TheAccomplice/Time/l3/l3.kicad_pcb

## KiCad design l3/l3.kicad_pcb (2025-02-14)

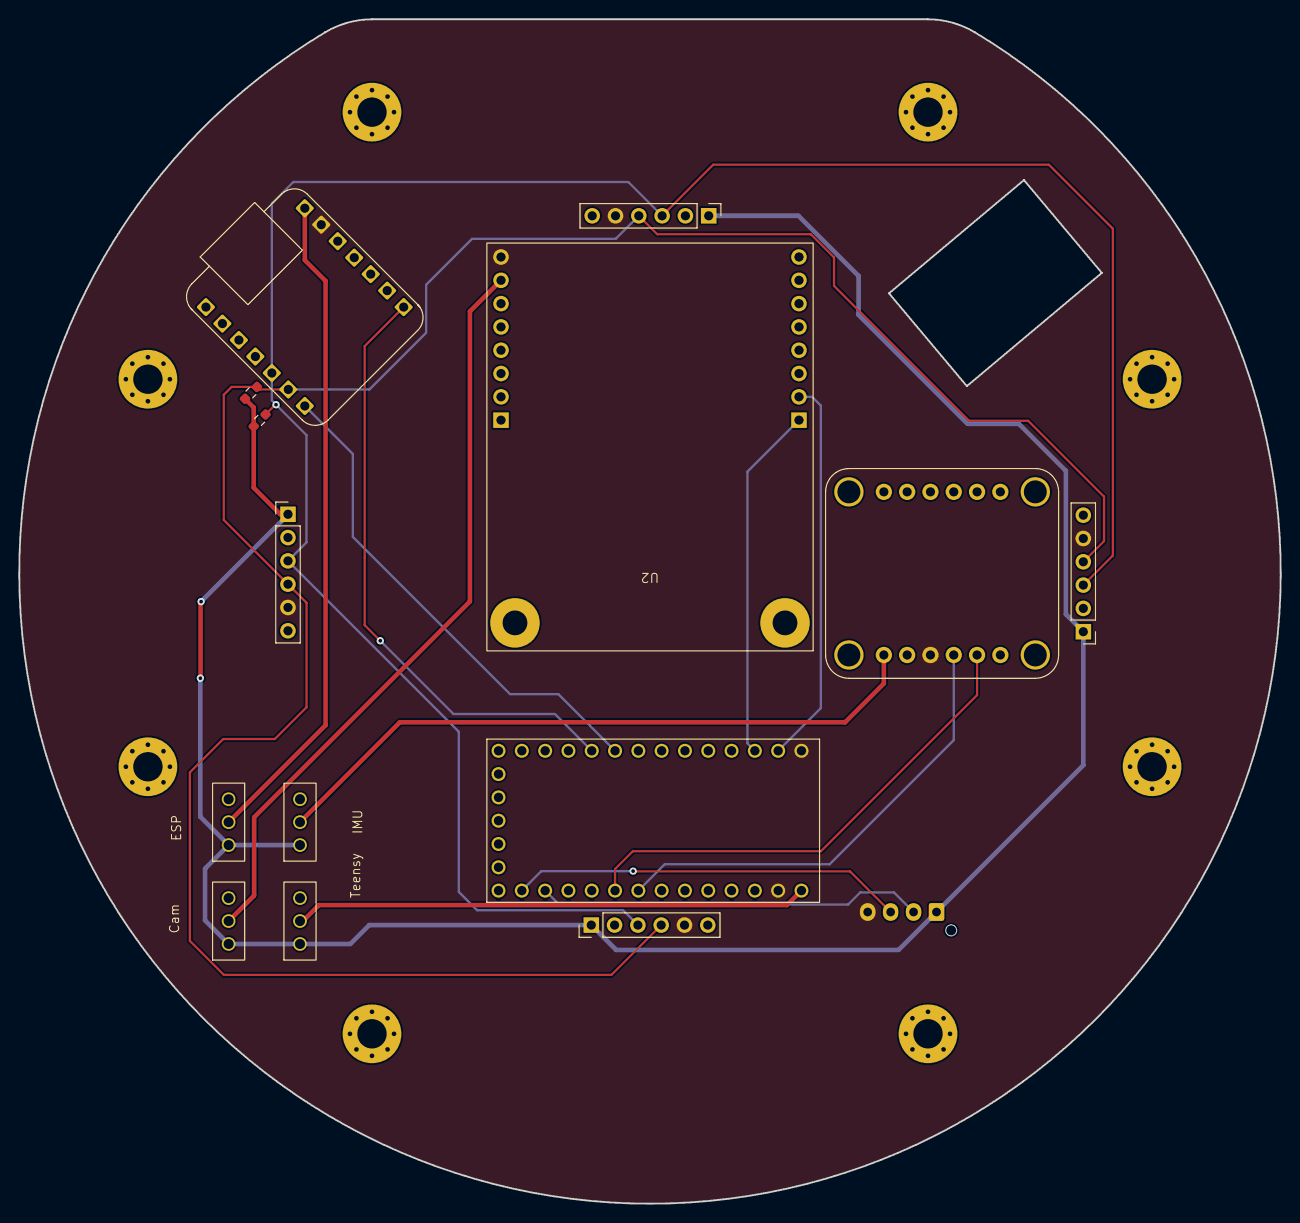
[picture p2: board l3.kicad_pcb from above]

Board: 2 copper layers, 137.5 x 129.1 mm, 23 parts (1 on the bottom side), 16 nets.

Parts:
Cam: SW_SPDT; SS12D00G3-2.5mm
ESP: SW_SPDT; SS12D00G3-2.5mm
H1, H2, H3, H4, H5, H6, H7, H8: MountingHole_Pad; MountingHole_3.2mm_M3_Pad_Via
IMU: SW_SPDT; SS12D00G3-2.5mm
J1: Conn_01x04; JST_XH_B4B-XH-AM_1x04_P2.50mm_Vertical
J2, J3, J4, J5: Conn_01x06; PinHeader_1x06_P2.54mm_Vertical
R1, R2: 1k; R_0603_1608Metric_Pad0.98x0.95mm_HandSolder
Teensy: SW_SPDT; SS12D00G3-2.5mm
U1: BNO085
U2: OpenMV
U3: xiao-esp32c3
U4: DEV-15583; MODULE_DEV-15583

Connections:
+5V: Cam.1 (A), ESP.1 (A), IMU.1 (A), J1.1, J2.1, J3.1, J4.1, J5.1, R1.2, R2.2, Teensy.1 (A)
/CameraSwitch: Cam.2 (B), U2.15 (VIN)
/CompassSwitch: IMU.2 (B), U1.0 (VIN)
/ESPSwitch: ESP.2 (B), U3.13 (5V)
/RXCam: U2.2 (P1), U4.0
/RXL2: J1.2, U4.15
/RXToF: U3.7 (D7), U4.8
/SCLComp: U1.3 (SCL/SCK/RX), U4.19
/SDAComp: U1.4 (SDA/MISO/TX), U4.18
/TXCam: U2.1 (P0), U4.1
/TXL2: J1.3, U4.14
/TXToF: U3.6 (D6), U4.7
/TeensySwitch: Teensy.2 (B), U4.VIN
GND: J1.4, J2.5, J3.5, J4.5, J5.5, U1.2 (GND), U2.16 (GND), U3.12 (GND), U4.G1, U4.G3 (GND)
SCLToF: J2.4, J3.4, J4.4, J5.4, R2.1, U3.5 (D5)
SDAToF: J2.3, J3.3, J4.3, J5.3, R1.1, U3.4 (D4)
