TheAccomplice/Time/l2/l2.kicad_pcb

## KiCad design l2/l2.kicad_pcb (2025-02-14)

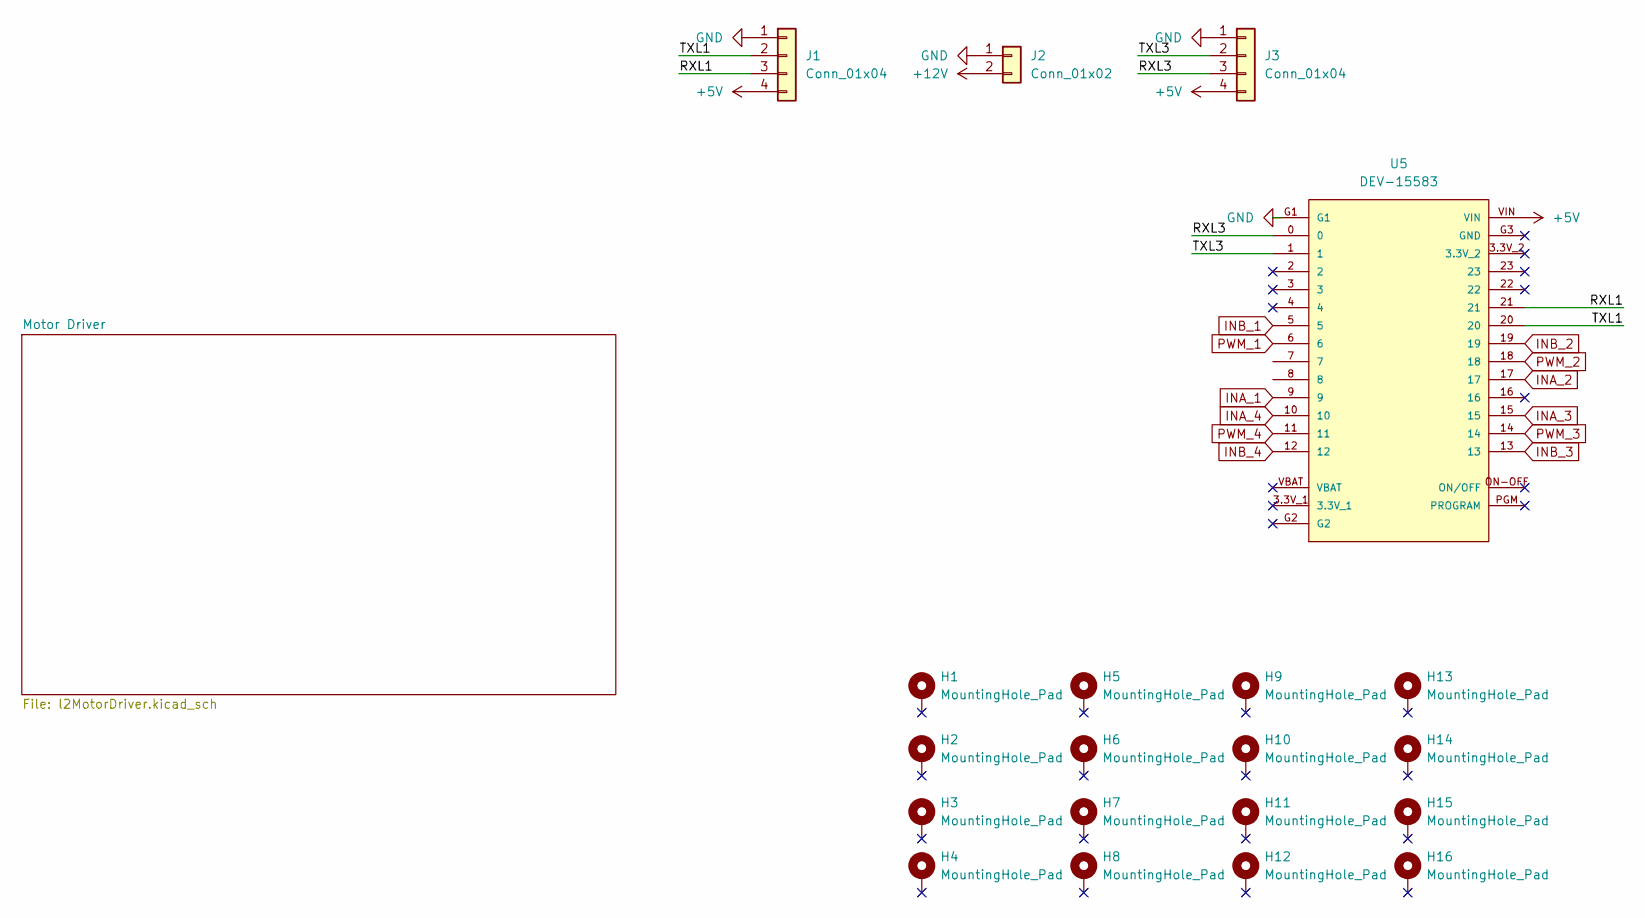
[picture p3: schematic l2.kicad_sch]

Parts:
H1, H2, H3, H4, H5, H6, H7, H8, H9, H10, H11, H12, H13, H14, H15, H16: MountingHole_Pad; MountingHole_3.2mm_M3_Pad_Via
J1, J3: Conn_01x04; JST_XH_B4B-XH-AM_1x04_P2.50mm_Vertical
J2: Conn_01x02; AMASS_XT60-M_1x02_P7.20mm_Vertical
U5: DEV-15583; MODULE_DEV-15583

Connections:
+5V: J1.4, J3.4, U5.VIN; also elsewhere on the board
+12V: J2.2; also elsewhere on the board
/RXL1: J1.3, U5.21
/RXL3: J3.3, U5.0
/TXL1: J1.2, U5.20
/TXL3: J3.2, U5.1
GND: J1.1, J2.1, J3.1, U5.G1; also elsewhere on the board
INA_1: U5.9; also elsewhere on the board
INA_2: U5.17; also elsewhere on the board
INA_3: U5.15; also elsewhere on the board
INA_4: U5.10; also elsewhere on the board
INB_1: U5.5; also elsewhere on the board
INB_2: U5.19; also elsewhere on the board
INB_3: U5.13; also elsewhere on the board
INB_4: U5.12; also elsewhere on the board
PWM_1: U5.6; also elsewhere on the board
PWM_2: U5.18; also elsewhere on the board
PWM_3: U5.14; also elsewhere on the board
PWM_4: U5.11; also elsewhere on the board

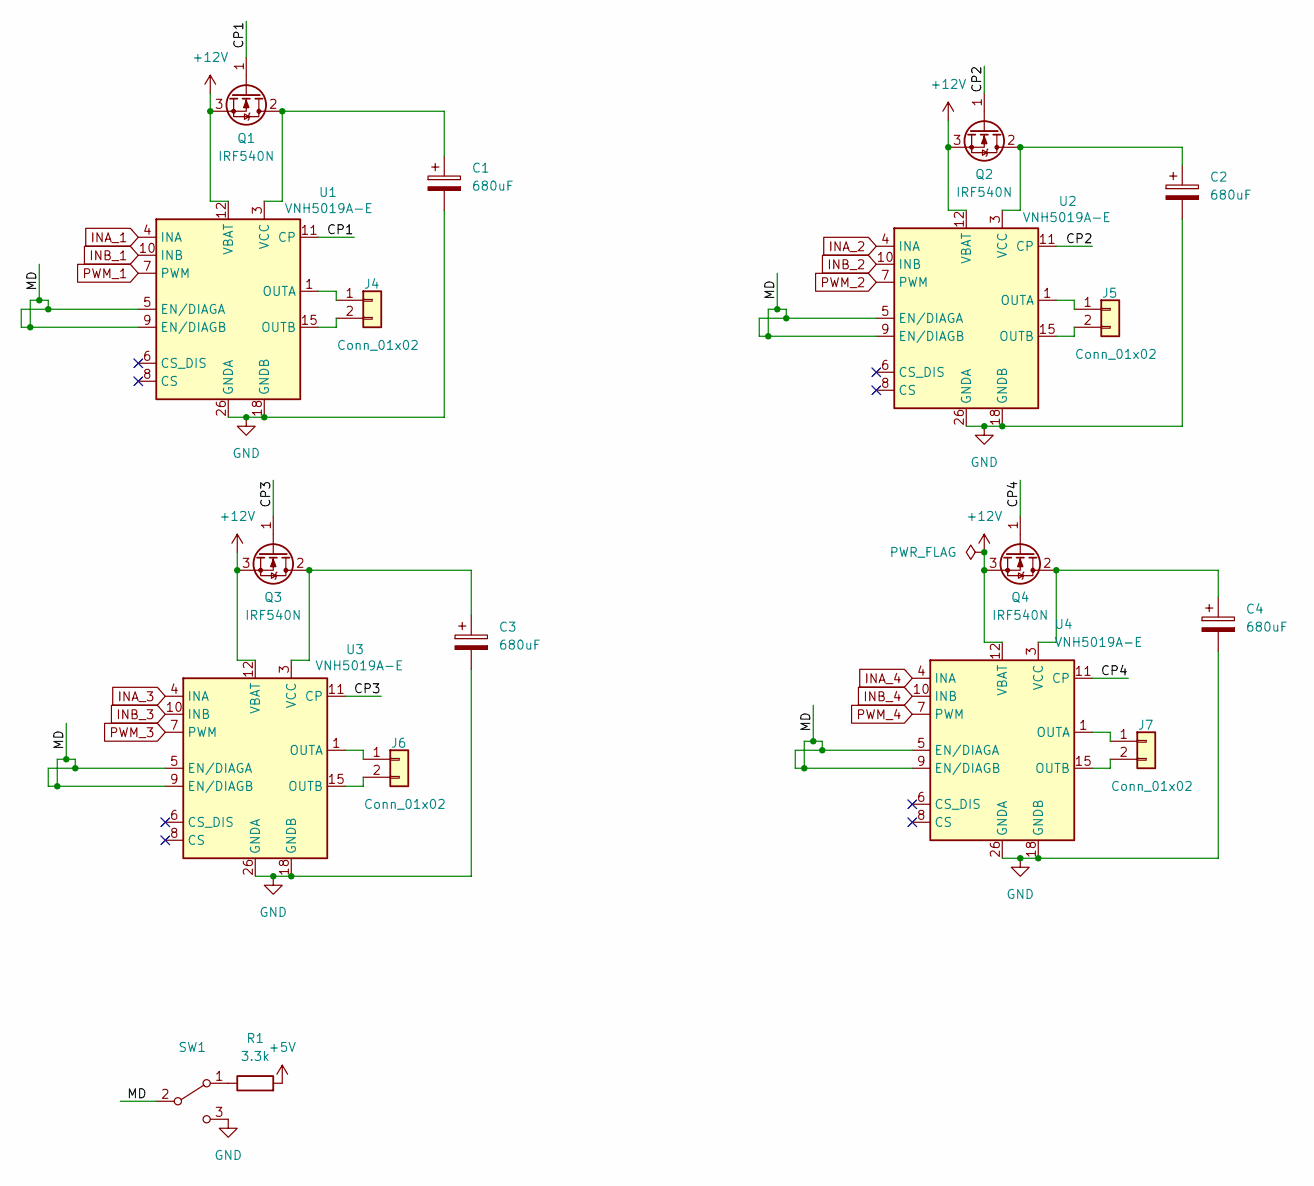
[picture p4: schematic l2MotorDriver.kicad_sch]

Parts:
C1, C2, C3, C4: 680uF; CP_Radial_D8.0mm_P3.50mm
J4, J5, J6, J7: Conn_01x02; AMASS_XT30UPB-F_1x02_P5.0mm_Vertical
Q1, Q2, Q3, Q4: IRF540N; TO-220-3_Vertical
R1: 3.3k; R_0603_1608Metric_Pad0.98x0.95mm_HandSolder
SW1: SW_SPDT; JST_XH_B3B-XH-AM_1x03_P2.50mm_Vertical
U1, U2, U3, U4: VNH5019A-E; VNH5019A-E_SO-30

Connections:
+5V: R1.2; also elsewhere on the board
+12V: Q1.3 (S), Q2.3 (S), Q3.3 (S), Q4.3 (S), U1.12 (VBAT), U2.12 (VBAT), U3.12 (VBAT), U4.12 (VBAT); also elsewhere on the board
/Motor Driver/CP1: Q1.1 (G), U1.11 (CP)
/Motor Driver/CP2: Q2.1 (G), U2.11 (CP)
/Motor Driver/CP3: Q3.1 (G), U3.11 (CP)
/Motor Driver/CP4: Q4.1 (G), U4.11 (CP)
/Motor Driver/MD: SW1.2 (B), U1.5 (EN/DIAGA), U1.9 (EN/DIAGB), U2.5 (EN/DIAGA), U2.9 (EN/DIAGB), U3.5 (EN/DIAGA), U3.9 (EN/DIAGB), U4.5 (EN/DIAGA), U4.9 (EN/DIAGB)
GND: C1.2, C2.2, C3.2, C4.2, SW1.3 (C), U1.18 (GNDB), U1.19 (GNDB), U1.20 (GNDB), U1.26 (GNDA), U1.27 (GNDA), U1.28 (GNDA), U2.18 (GNDB), U2.19 (GNDB), U2.20 (GNDB), U2.26 (GNDA), U2.27 (GNDA), U2.28 (GNDA), U3.18 (GNDB), U3.19 (GNDB), U3.20 (GNDB), U3.26 (GNDA), U3.27 (GNDA), U3.28 (GNDA), U4.18 (GNDB), U4.19 (GNDB), U4.20 (GNDB), U4.26 (GNDA), U4.27 (GNDA), U4.28 (GNDA); also elsewhere on the board
INA_1: U1.4 (INA); also elsewhere on the board
INA_2: U2.4 (INA); also elsewhere on the board
INA_3: U3.4 (INA); also elsewhere on the board
INA_4: U4.4 (INA); also elsewhere on the board
INB_1: U1.10 (INB); also elsewhere on the board
INB_2: U2.10 (INB); also elsewhere on the board
INB_3: U3.10 (INB); also elsewhere on the board
INB_4: U4.10 (INB); also elsewhere on the board
unnamed: J4.1, U1.1 (OUTA), U1.25 (OUTA), U1.30 (OUTA), U1.33 (OUTA)
unnamed: J4.2, U1.15 (OUTB), U1.16 (OUTB), U1.21 (OUTB), U1.32 (OUTB)
unnamed: J5.1, U2.1 (OUTA), U2.25 (OUTA), U2.30 (OUTA), U2.33 (OUTA)
unnamed: J5.2, U2.15 (OUTB), U2.16 (OUTB), U2.21 (OUTB), U2.32 (OUTB)
unnamed: J6.1, U3.1 (OUTA), U3.25 (OUTA), U3.30 (OUTA), U3.33 (OUTA)
unnamed: J6.2, U3.15 (OUTB), U3.16 (OUTB), U3.21 (OUTB), U3.32 (OUTB)
unnamed: J7.1, U4.1 (OUTA), U4.25 (OUTA), U4.30 (OUTA), U4.33 (OUTA)
unnamed: J7.2, U4.15 (OUTB), U4.16 (OUTB), U4.21 (OUTB), U4.32 (OUTB)
unnamed: C1.1, Q1.2 (D), U1.3 (VCC), U1.13 (VCC), U1.23 (VCC), U1.31 (VCC)
unnamed: C2.1, Q2.2 (D), U2.3 (VCC), U2.13 (VCC), U2.23 (VCC), U2.31 (VCC)
unnamed: C3.1, Q3.2 (D), U3.3 (VCC), U3.13 (VCC), U3.23 (VCC), U3.31 (VCC)
unnamed: C4.1, Q4.2 (D), U4.3 (VCC), U4.13 (VCC), U4.23 (VCC), U4.31 (VCC)
unnamed: R1.1, SW1.1 (A)
PWM_1: U1.7 (PWM); also elsewhere on the board
PWM_2: U2.7 (PWM); also elsewhere on the board
PWM_3: U3.7 (PWM); also elsewhere on the board
PWM_4: U4.7 (PWM); also elsewhere on the board

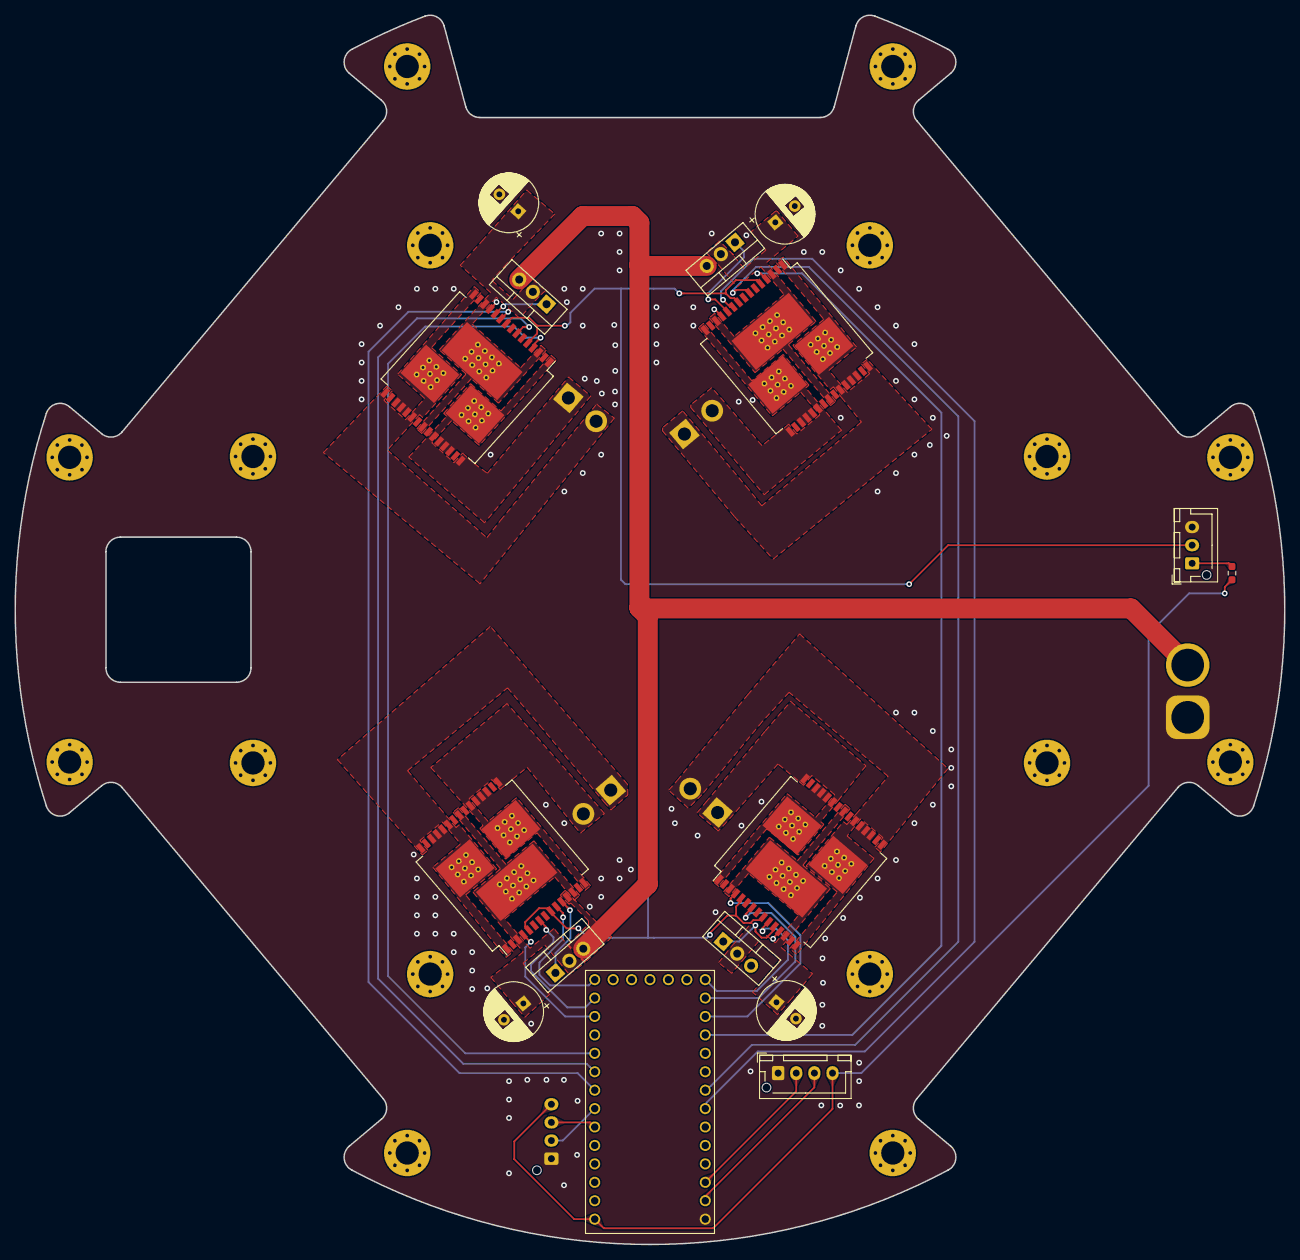
[picture p5: board l2.kicad_pcb from above]

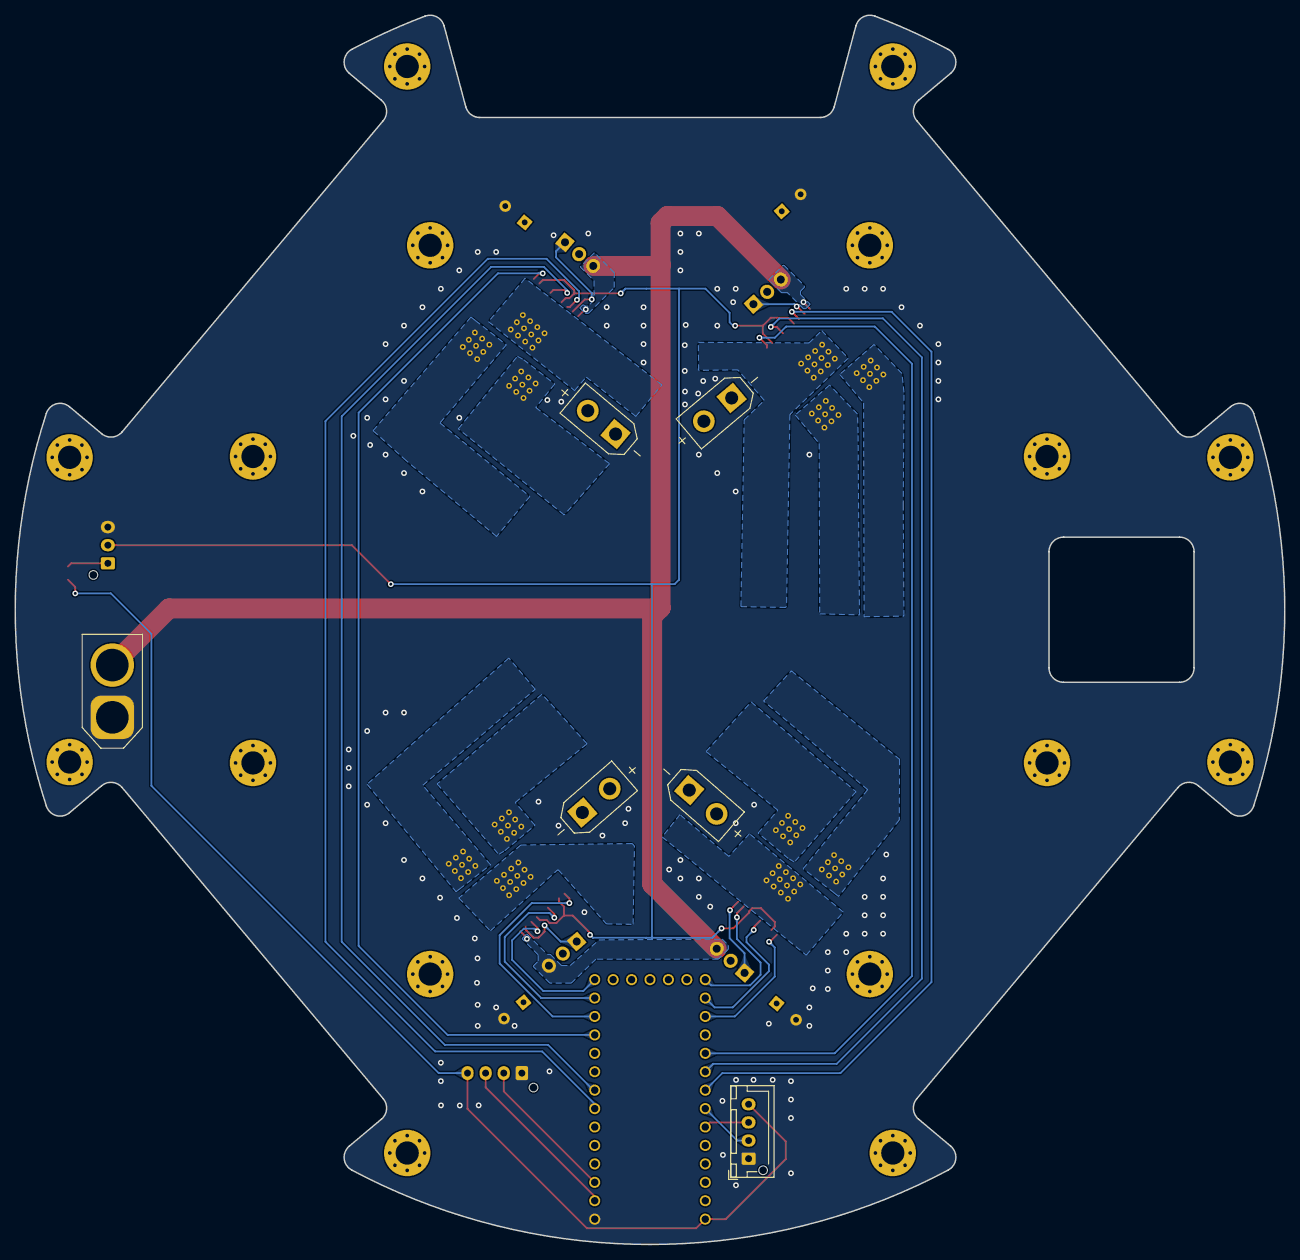
[picture p6: board l2.kicad_pcb from below]

Board: 2 copper layers, 175.0 x 169.4 mm, 38 parts (6 on the bottom side), 37 nets.
