TheAccomplice/Time/l1/l1.kicad_pcb

## KiCad design l1/l1.kicad_pcb (2024-11-28)

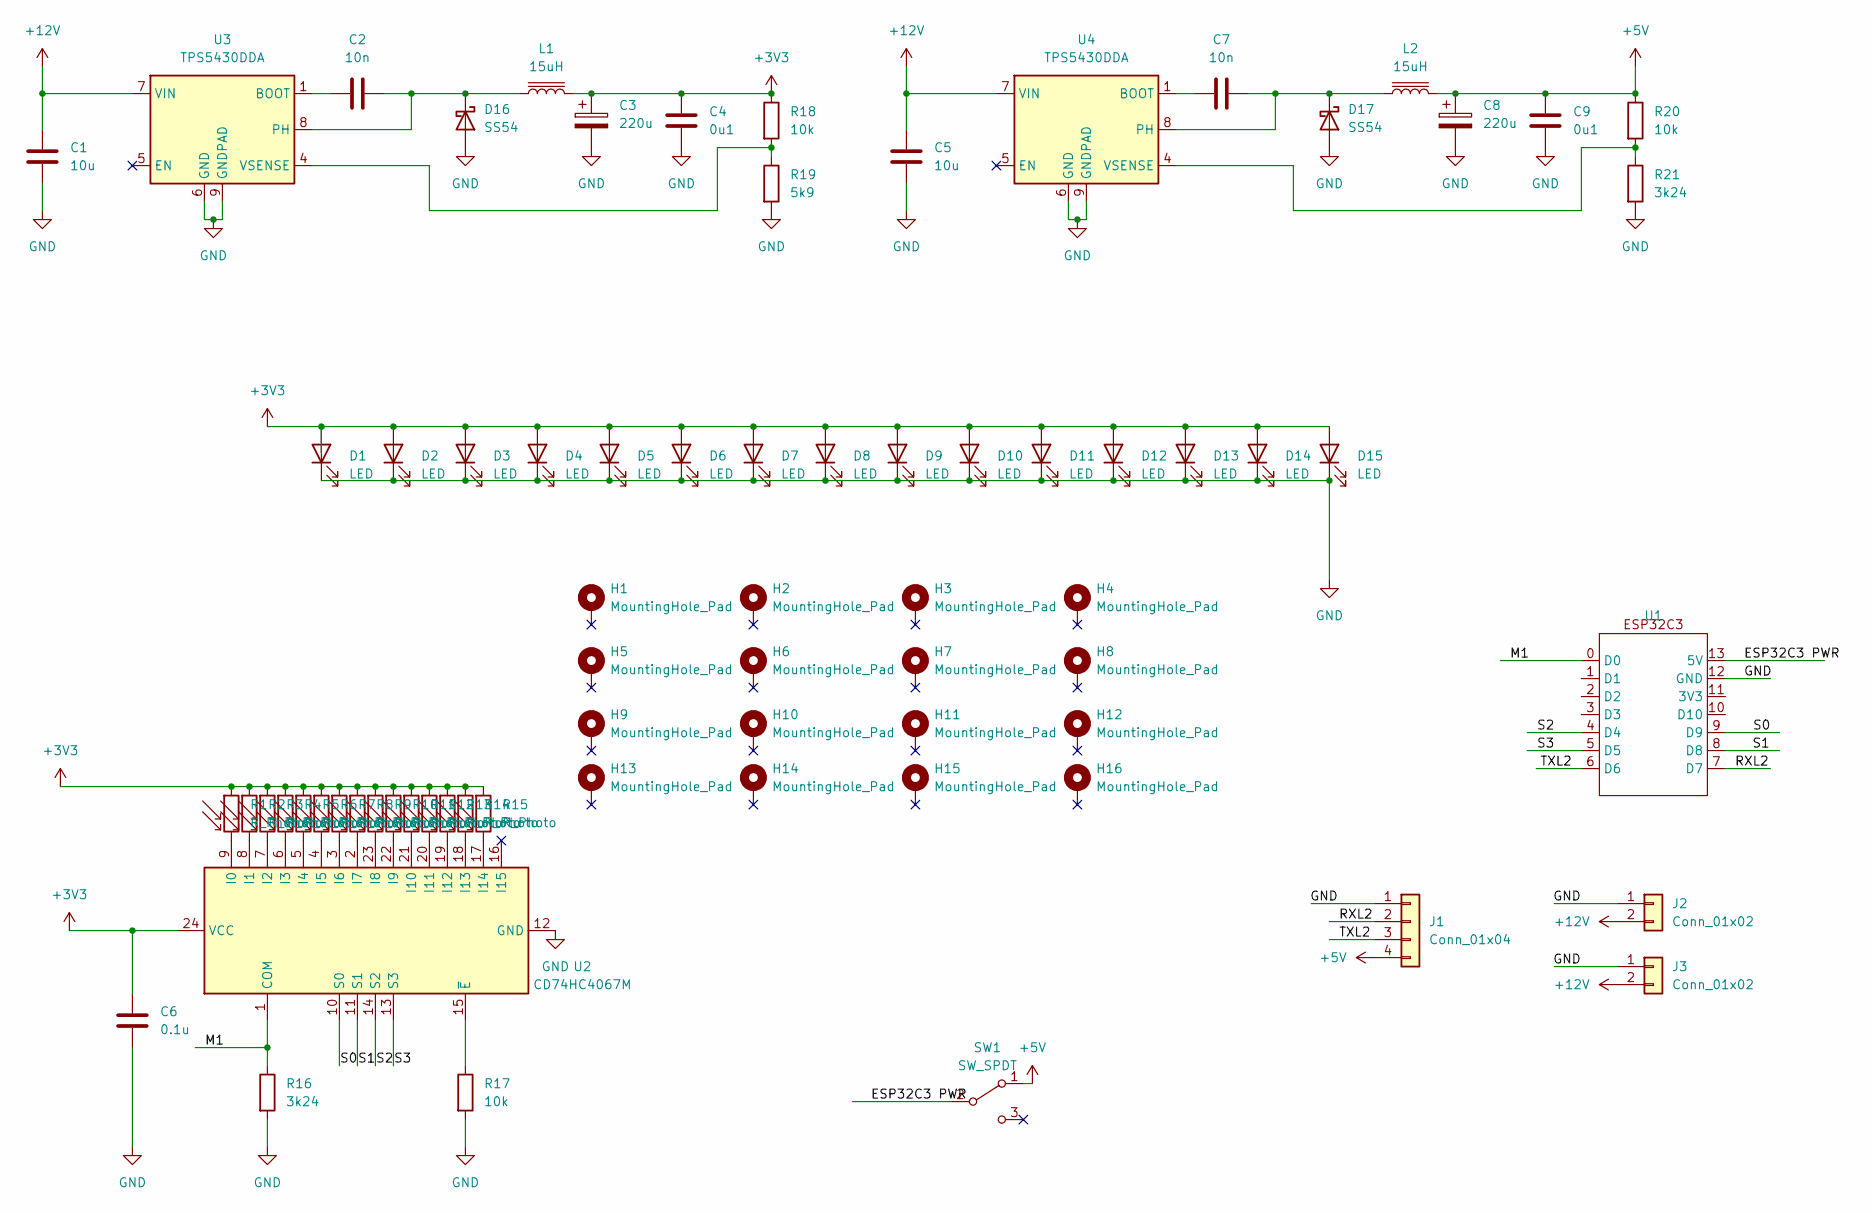
[picture p7: schematic l1.kicad_sch]

Parts:
C1, C5: 10u; C_0603_1608Metric_Pad1.08x0.95mm_HandSolder
C2, C7: 10n; C_0603_1608Metric_Pad1.08x0.95mm_HandSolder
C3, C8: 220u; CP_EIA-7343-15_Kemet-W_Pad2.25x2.55mm_HandSolder
C4, C9: 0u1; C_0603_1608Metric_Pad1.08x0.95mm_HandSolder
C6: 0.1u; C_0603_1608Metric_Pad1.08x0.95mm_HandSolder
D1, D2, D3, D4, D5, D6, D7, D8, D9, D10, D11, D12, D13, D14, D15: LED; LED_PLCC_2835_Handsoldering
D16, D17: SS54; D_SMA_Handsoldering
H1, H2, H3, H4, H5, H6, H7, H8, H9, H10, H11, H12, H13, H14, H15, H16: MountingHole_Pad; MountingHole_3.2mm_M3_Pad_Via
J1: Conn_01x04; JST_XH_B4B-XH-AM_1x04_P2.50mm_Vertical
J2, J3: Conn_01x02; AMASS_XT60-M_1x02_P7.20mm_Vertical
L1, L2: 15uH; L_Bourns_SRR1208_12.7x12.7mm
R1, R2, R3, R4, R5, R6, R7, R8, R9, R10, R11, R12, R13, R14, R15: R_Photo; LED_0603_1608Metric
R16, R21: 3k24; R_0603_1608Metric_Pad0.98x0.95mm_HandSolder
R17, R18, R20: 10k; R_0603_1608Metric_Pad0.98x0.95mm_HandSolder
R19: 5k9; R_0603_1608Metric_Pad0.98x0.95mm_HandSolder
SW1: SW_SPDT; SS12D00G3-2.5mm
U1: xiao-esp32c3
U2: CD74HC4067M; SOIC-24W_7.5x15.4mm_P1.27mm
U3, U4: TPS5430DDA; TI_SO-PowerPAD-8_ThermalVias

Connections:
+3V3: C3.1, C4.1, C6.1, D1.2 (A), D2.2 (A), D3.2 (A), D4.2 (A), D5.2 (A), D6.2 (A), D7.2 (A), D8.2 (A), D9.2 (A), D10.2 (A), D11.2 (A), D12.2 (A), D13.2 (A), D14.2 (A), D15.2 (A), L1.2, R1.1, R2.1, R3.1, R4.1, R5.1, R6.1, R7.1, R8.1, R9.1, R10.1, R11.1, R12.1, R13.1, R14.1, R15.1, R18.1, U2.24 (VCC)
+5V: C8.1, C9.1, J1.4, L2.2, R20.1, SW1.1 (A)
+12V: C1.1, C5.1, J2.2, J3.2, U3.7 (VIN), U4.7 (VIN)
/ESP32C3 PWR: SW1.2 (B), U1.13 (5V)
/M1: R16.1, U1.0 (D0), U2.1 (COM)
/RXL2: J1.2, U1.7 (D7)
/S0: U1.9 (D9), U2.10 (S0)
/S1: U1.8 (D8), U2.11 (S1)
/S2: U1.4 (D4), U2.14 (S2)
/S3: U1.5 (D5), U2.13 (S3)
/TXL2: J1.3, U1.6 (D6)
GND: C1.2, C3.2, C4.2, C5.2, C6.2, C8.2, C9.2, D1.1 (K), D2.1 (K), D3.1 (K), D4.1 (K), D5.1 (K), D6.1 (K), D7.1 (K), D8.1 (K), D9.1 (K), D10.1 (K), D11.1 (K), D12.1 (K), D13.1 (K), D14.1 (K), D15.1 (K), D16.2 (A), D17.2 (A), J1.1, J2.1, J3.1, R16.2, R17.2, R19.2, R21.2, U1.12 (GND), U2.12 (GND), U3.6 (GND), U3.9 (GNDPAD), U4.6 (GND), U4.9 (GNDPAD)
unnamed: C2.2, D16.1 (K), L1.1, U3.8 (PH)
unnamed: C7.2, D17.1 (K), L2.1, U4.8 (PH)
unnamed: R1.2, U2.9 (I0)
unnamed: R2.2, U2.8 (I1)
unnamed: R3.2, U2.7 (I2)
unnamed: R4.2, U2.6 (I3)
unnamed: R5.2, U2.5 (I4)
unnamed: R6.2, U2.4 (I5)
unnamed: R7.2, U2.3 (I6)
unnamed: R8.2, U2.2 (I7)
unnamed: R9.2, U2.23 (I8)
unnamed: R10.2, U2.22 (I9)
unnamed: R11.2, U2.21 (I10)
unnamed: R12.2, U2.20 (I11)
unnamed: R13.2, U2.19 (I12)
unnamed: R14.2, U2.18 (I13)
unnamed: R15.2, U2.17 (I14)
unnamed: R17.1, U2.15 (~E)
unnamed: C2.1, U3.1 (BOOT)
unnamed: R18.2, R19.1, U3.4 (VSENSE)
unnamed: C7.1, U4.1 (BOOT)
unnamed: R20.2, R21.1, U4.4 (VSENSE)

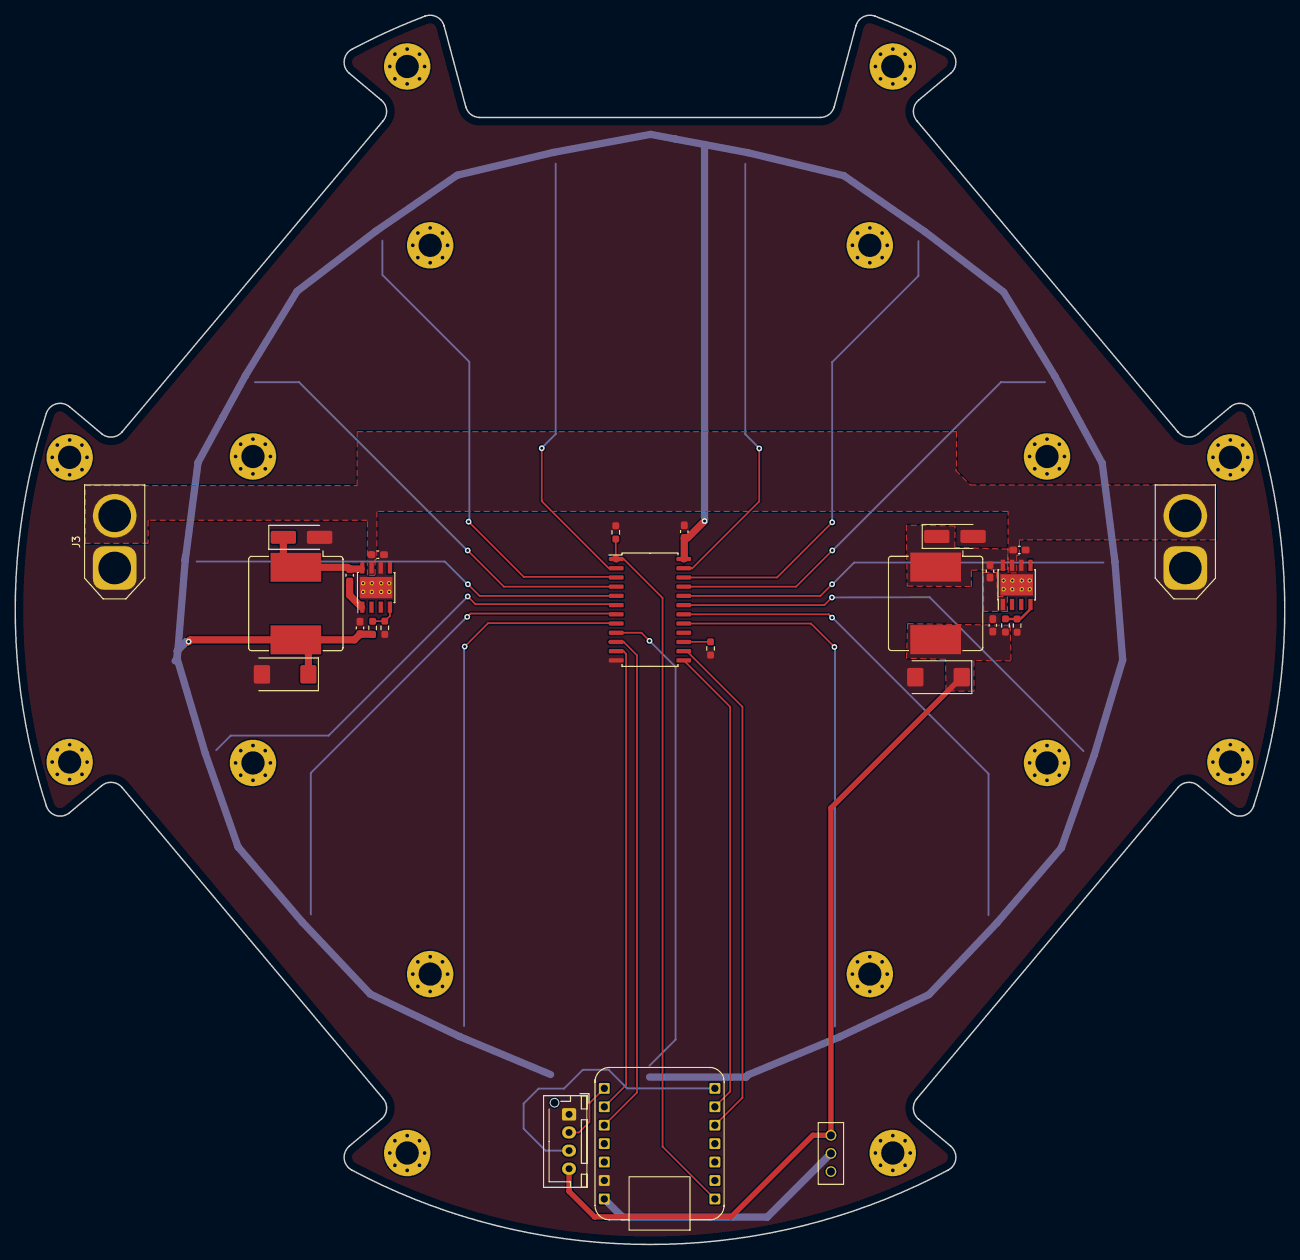
[picture p8: board l1.kicad_pcb from above]

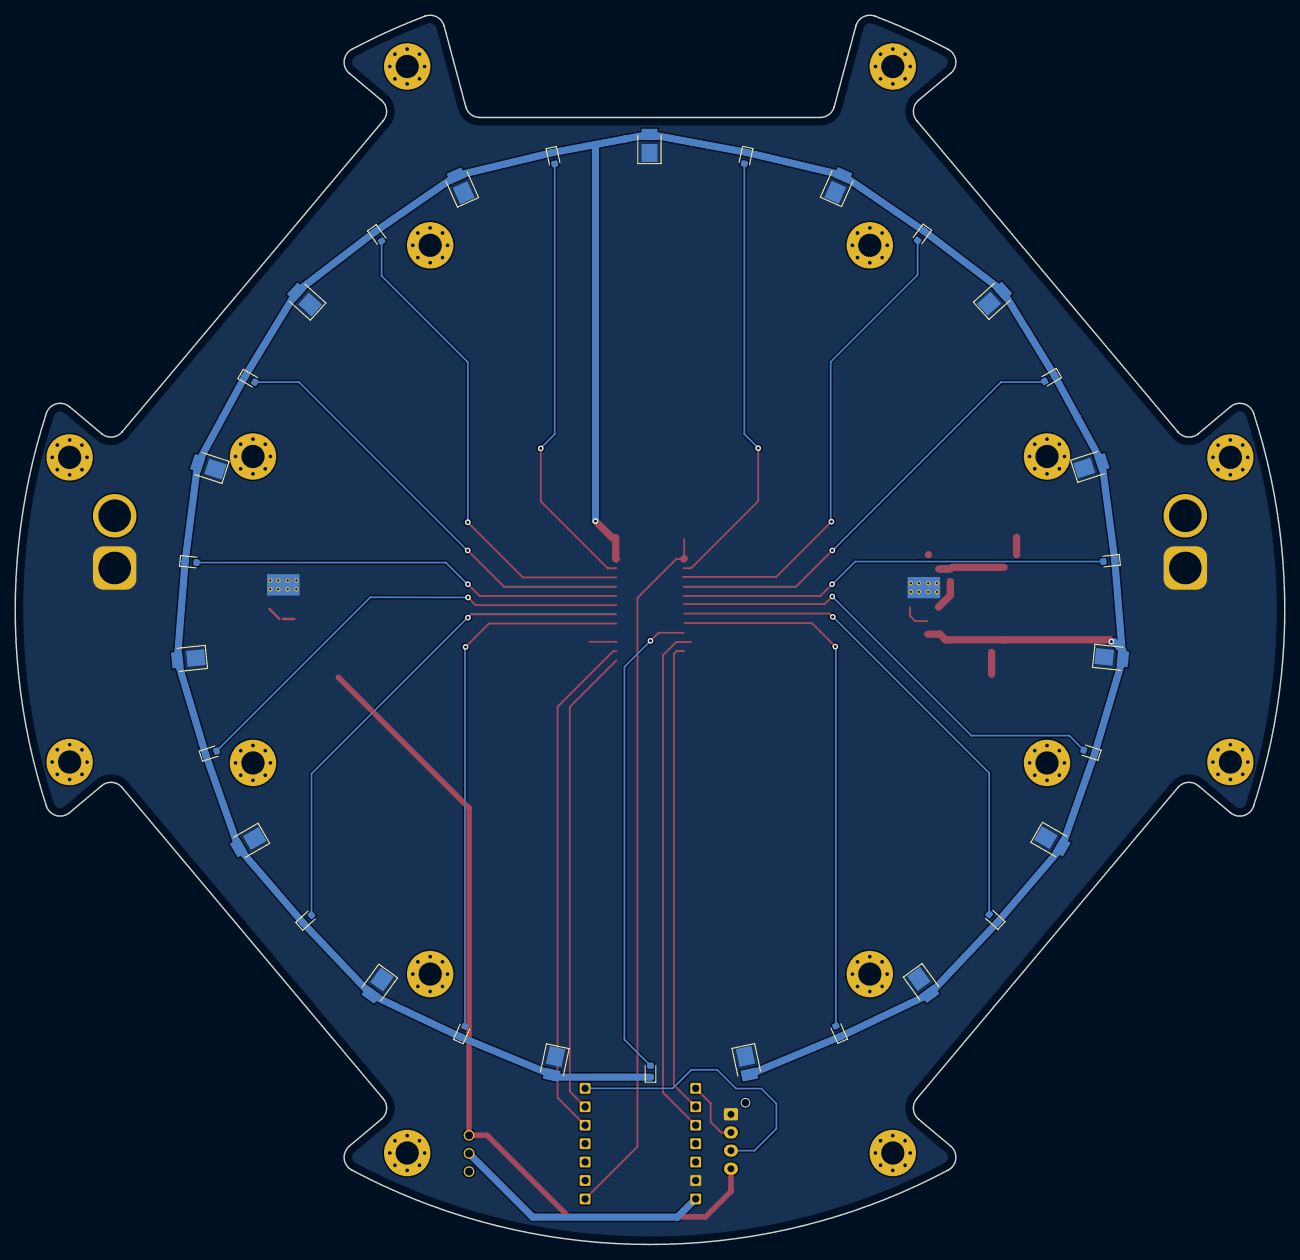
[picture p9: board l1.kicad_pcb from below]

Board: 2 copper layers, 175.0 x 169.4 mm, 73 parts (30 on the bottom side), 34 nets.
