TheAccomplice/Time/(commit log)

2024-07-05 Copy Over
    [Seeed Studio XIAO-ESP32-C3.step, buck.kicad_pcb, buck.kicad_sch, l1.kicad_pcb, l1.kicad_sch, l2.kicad_pcb, l2.kicad_sch, l3.kicad_pcb]
2024-07-05 readd trace
    [l3.kicad_pcb]
2024-07-05 2024 folder
    [Seeed Studio XIAO-ESP32-C3.step, buck.kicad_pcb, buck.kicad_sch, l1.kicad_pcb, l1.kicad_sch, l2.kicad_pcb, l2.kicad_sch, l3.kicad_pcb]
2024-07-05 remove trace test
    [l3.kicad_pcb]
2024-07-05 replace trace test
    [l3.kicad_pcb]
2024-07-05 another test
    [l3.kicad_pcb]
2024-07-05 add back trace
    [l3.kicad_pcb]
2024-07-05 pcb lck removed
2024-07-12 PCB_done
    Rearrange traces
    [l3.kicad_pcb]
2024-07-12 PCB done
    [l3.kicad_pcb]
2024-07-17 17/7 final
    [l2.kicad_sch]
2024-07-26 Motor Driver sch very wonky draft
    [l2.kicad_sch]
2024-07-26 26/7 final
    [l2.kicad_sch]
2024-07-31 31/7 final
    [l2.kicad_sch]
2024-08-02 Refined motor driver schematics
    L2 schematics basically good to go might need final senior's review
    [l2.kicad_sch, l2MotorDriver.kicad_sch, untitled.kicad_sch]
2024-08-07 7/8 part_I
    [l2.kicad_sch, l2MotorDriver.kicad_sch]
2024-08-07 7/8 final
    [l2.kicad_pcb, l2MotorDriver.kicad_sch]
2024-08-14 14/8 final
    [l2.kicad_sch, l2MotorDriver.kicad_sch]
2024-08-16 Fixed motor driver error
    VL53L1X is actual one
    [l3.kicad_sch, l3_tof.kicad_sch, untitled.kicad_sch]
2024-08-16 16/8 final
    [l2.kicad_pcb, l2.kicad_sch, l2MotorDriver.kicad_sch, l3.kicad_sch]
2024-08-21 21/8 final
    about 10% done l2 pcb
    [l2.kicad_pcb, l2.kicad_sch, l2MotorDriver.kicad_sch]
2024-08-21 21/8 final2
    still about 10% done l2 pcb
2024-08-28 28/8 final
    resistors for motor driver removed as it was too cumbersome to do the traces and is also completely optional
    [l2.kicad_pcb, l2MotorDriver.kicad_sch]
2024-09-04 4/9 final
    some cursed motor driver routing
    [l2.kicad_pcb]
2024-09-05 5/9 final
    fixed the problem with motor driver schematics
    [l2.kicad_pcb, l2.kicad_sch, l2MotorDriver.kicad_sch]
2024-09-08 edited motor driver pcb
    [l2.kicad_pcb]
2024-11-24 final 0.9
    [l1.kicad_pcb, l1.kicad_sch, l2.kicad_pcb, l2.kicad_sch, l2MotorDriver.kicad_sch, l3.kicad_pcb, l3.kicad_sch, l3_tof.kicad_sch]
2024-11-28 final 0.91
    fixed:
    switched analog signal pin on l1 esp32c3 to a0 since a1 not working
    silkscreen is now properly placed
    traces are adjusted on l1
    [l1.kicad_pcb, l1.kicad_sch, l2.kicad_pcb]
2024-11-29 tf luna
    gerber created for l1 and l2
    l3 changed the tof from vl53l1x to tf luna
    [bom.csv, designators.csv, l2.kicad_pcb, l3.kicad_pcb, l3.kicad_sch, l3_tof.kicad_sch, positions.csv]
2024-11-30 tf luna mount complete
    adjusted a lot of stuff
    [l3.kicad_pcb]
2024-12-01 final 0.92
    l3 traces going from the switch to vin of components 0.5mm just to be sure
    [l3.kicad_pcb]
2024-12-11 final 1.0
    [bom.csv, designators.csv, l3.kicad_pcb, positions.csv]
2025-01-15 v1.091
    fix via over silkscreen
    [l2.kicad_pcb]
2025-02-05 folder structure rework
    [Seeed Studio XIAO-ESP32-C3.step, bom.csv, buck.kicad_pcb, buck.kicad_sch, designators.csv, l1.kicad_pcb, l1.kicad_sch, l2.kicad_pcb]
2025-02-13 v2.0
    l2 l3 done for print
    [bom.csv, designators.csv, l2.kicad_pcb, l2MotorDriver.kicad_sch, l3.kicad_pcb, positions.csv]
2025-02-14 v2.1
    fixed some stuff
    [l2.kicad_pcb, l2.kicad_sch, l2MotorDriver.kicad_sch, l3.kicad_pcb]
